RamiroSGaspar/ChalecoSOC_2023/AppMovil_ChalecoSOC/Codigo_bloques_APPChalecoSOC.jpeg

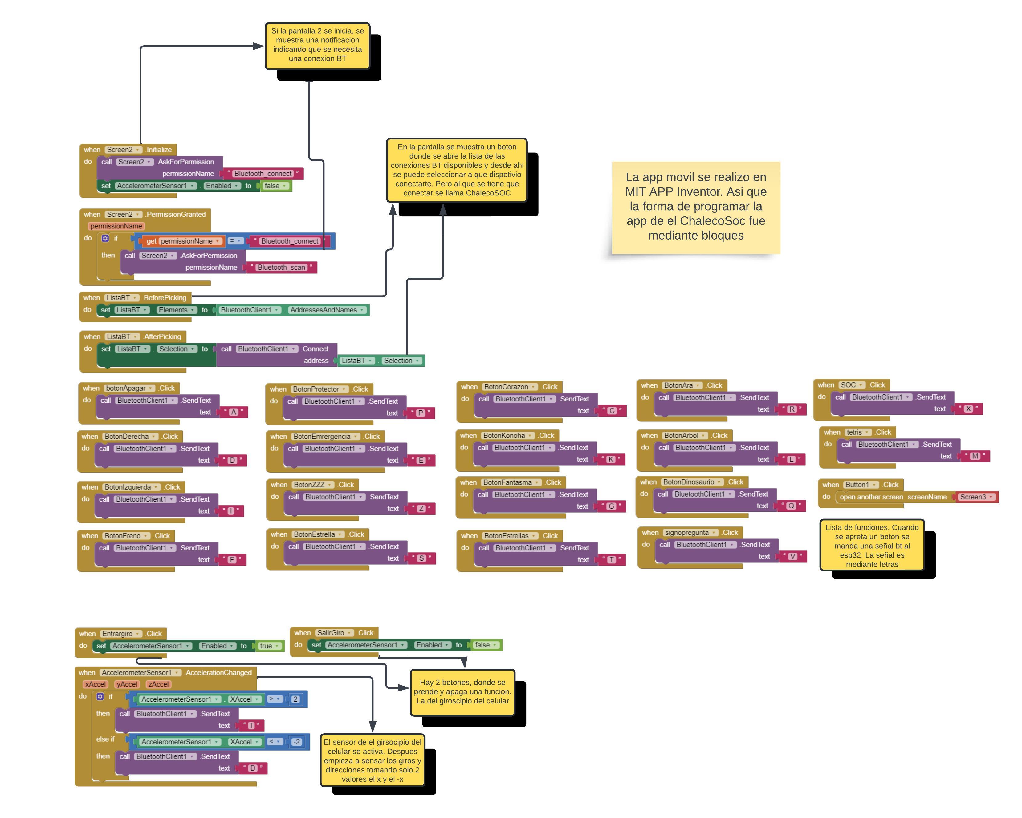
AppMovil_ChalecoSOC/Codigo_bloques_APPChalecoSOC.jpeg
