RamiroSGaspar/ChalecoSOC_2023/Software_ChalecoSOC/CodigoESP32/CodigoESP32.ino

// Autor: Ramiro Sebastian Gaspar
// Fecha: 27/08/24
// Proyecto: Chaleco SOC
// Institucion: E.E.T 3139 Gral. M.M de Guemes, Salta Capital
// Version: 1.0 (version final)

// Proposito: Este es un programa que se une con el hardware de el ChalecoSOC. Este codigo permite que el microcontrolador
//pueda recibir señales bt que contienen letras. Estas letras son interpretadas por el codigo y muestra manda una sucecion
//de comandos para que las luces led inteligentes puedan interpretarlas y traducirla a los distintos colores, asi formando
//la imagen o la animacion.

// Notas: Las letras ya estan almacenadas en la aplicacion movil asi que si el esp32 detecta que se pulsa una letra se manda
//las señales a los leds. Ademas, este codigo no es funcional en otros microcontroladores como Arduino UNO, debido a que los
//comandos de las secuencias de luces ocupan mucho espacio, y esos micros no cuentan con la capacidad para almacenar tantos,
//puede funcionar si se le amplian la memoria pero se convierte en en gasto mas.


//se importan las librerias necesarias
#include <Adafruit_NeoPixel.h> //libreria que permite el control de los leds
#include <BluetoothSerial.h> //libreria que permite el uso del bluetooth del esp32

int brillo = 12; // se declara el brillo de los leds
int leds = 288; // cantidad de leds
int tiempo = 1000; //este se utiliza para funciones extras

Adafruit_NeoPixel tira = Adafruit_NeoPixel(leds, 13, NEO_GRB + NEO_KHZ800); //se declara el pin de datos y el nombre de esta "tira"
BluetoothSerial SerialBT; //esta instancia se utiliza para configurar y gestionar la comunicación Bluetooth


void setup() { // este inicia el programa
  tira.begin(); // se utiliza en un proyecto que controla una tira de luces
  tira.setBrightness(brillo); // se utiliza para controlar el brillo
  tira.show(); // prende los pixeles con su configuracion 
  Serial.begin(115200); // inicializa  la comunicación serial en una placa 
  SerialBT.begin("ChalecoSOC"); // es el nombre que aparece en los dispositivos que se conecten al esp32
}

void loop() { // ejecuta continuamente el programa
  
  if (SerialBT.available()){ // condicion que si el bt esta activado entonces...
    char BT = SerialBT.read(); //  lee datos de una conexión Bluetooth a través de un módulo Bluetooth configurado previamente
  
    switch (BT) { // lista de los datos
      //FUNCIONES DE CICLISMO:
//apagar
      case 'A':
      tira.setPixelColor(0,0,0,0);tira.setPixelColor(1,0,0,0);tira.setPixelColor(2,0,0,0);tira.setPixelColor(3,0,0,0);tira.setPixelColor(4,0,0,0);tira.setPixelColor(5,0,0,0);tira.setPixelColor(6,0,0,0);tira.setPixelColor(7,0,0,0);tira.setPixelColor(8,0,0,0);tira.setPixelColor(9,0,0,0);tira.setPixelC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
xelColor(195,255,255,0);tira.setPixelColor(196,0,0,0);tira.setPixelColor(197,0,0,0);tira.setPixelColor(198,0,0,0);tira.setPixelColor(199,0,0,0);tira.setPixelColor(200,0,0,0);tira.setPixelColor(201,0,0,0);tira.setPixelColor(202,0,0,0);tira.setPixelColor(203,0,0,0);tira.setPixelColor(204,0,0,0);tira.setPixelColor(205,0,0,0);tira.setPixelColor(206,255,255,0);tira.setPixelColor(207,255,255,0);tira.setPixelColor(208,0,0,0);tira.setPixelColor(209,255,255,0);tira.setPixelColor(210,255,255,0);tira.setPixelColor(211,255,255,0);tira.setPixelColor(212,255,255,0);tira.setPixelColor(213,0,0,0);tira.setPixelColor(214,0,0,0);tira.setPixelColor(215,0,0,0);tira.setPixelColor(216,0,0,0);tira.setPixelColor(217,0,0,0);tira.setPixelColor(218,0,0,0);tira.setPixelColor(219,0,0,0);tira.setPixelColor(220,0,0,0);tira.setPixelColor(221,0,0,0);tira.setPixelColor(222,0,0,0);tira.setPixelColor(223,0,0,0);tira.setPixelColor(224,255,255,0);tira.setPixelColor(225,255,255,0);tira.setPixelColor(226,255,255,0);tira.setPixelColor(227,255,255,0);tira.setPixelColor(228,255,255,0);tira.setPixelColor(229,255,255,0);tira.setPixelColor(230,0,0,0);tira.setPixelColor(231,0,0,0);tira.setPixelColor(232,0,0,0);tira.setPixelColor(233,0,0,0);tira.setPixelColor(234,0,0,0);tira.setPixelColor(235,0,0,0);tira.setPixelColor(236,0,0,0);tira.setPixelColor(237,0,0,0);tira.setPixelColor(238,0,0,0);tira.setPixelColor(239,0,0,0);tira.setPixelColor(240,0,0,0);tira.setPixelColor(241,0,0,0);tira.setPixelColor(242,255,255,0);tira.setPixelColor(243,255,255,0);tira.setPixelColor(244,255,255,0);tira.setPixelColor(245,255,255,0);tira.setPixelColor(246,255,255,0);tira.setPixelColor(247,0,0,0);tira.setPixelColor(248,0,0,0);tira.setPixelColor(249,0,0,0);tira.setPixelColor(250,0,0,0);tira.setPixelColor(251,0,0,0);tira.setPixelColor(252,0,0,0);tira.setPixelColor(253,0,0,0);tira.setPixelColor(254,0,0,0);tira.setPixelColor(255,0,0,0);tira.setPixelColor(256,0,0,0);tira.setPixelColor(257,0,0,0);tira.setPixelColor(258,0,0,0);tira.setPixelColor(259,0,0,0);tira.setPixelColor(260,255,255,0);tira.setPixelColor(261,255,255,0);tira.setPixelColor(262,255,255,0);tira.setPixelColor(263,255,255,0);tira.setPixelColor(264,0,0,0);tira.setPixelColor(265,0,0,0);tira.setPixelColor(266,0,0,0);tira.setPixelColor(267,0,0,0);tira.setPixelColor(268,0,0,0);tira.setPixelColor(269,0,0,0);tira.setPixelColor(270,0,0,0);tira.setPixelColor(271,0,0,0);tira.setPixelColor(272,0,0,0);tira.setPixelColor(273,0,0,0);tira.setPixelColor(274,0,0,0);tira.setPixelColor(275,0,0,0);tira.setPixelColor(276,0,0,0);tira.setPixelColor(277,0,0,0);tira.setPixelColor(278,0,0,0);tira.setPixelColor(279,0,0,0);tira.setPixelColor(280,0,0,0);tira.setPixelColor(281,0,0,0);tira.setPixelColor(282,0,0,0);tira.setPixelColor(283,0,0,0);tira.setPixelColor(284,0,0,0);tira.setPixelColor(285,0,0,0);tira.setPixelColor(286,0,0,0);tira.setPixelColor(287,0,0,0);
      tira.show();
      break;
//Izquierda
      case'I':
      tira.setPixelColor(0,0,0,0);tira.setPixelColor(1,0,0,0);tira.setPixelColor(2,0,0,0);tira.setPixelColor(3,0,0,0);tira.setPixelColor(4,0,0,0);tira.setPixelColor(5,0,0,0);tira.setPixelColor(6,255,255,0);tira.setPixelColor(7,255,255,0);tira.setPixelColor(8,255,255,0);tira.setPixelColor(9,255,255,0);tira.setPixelColor(10,0,0,0);tira.setPixelColor(11,0,0,0);tira.setPixelColor(12,0,0,0);tira.setPixelColor(13,0,0,0);tira.setPixelColor(14,0,0,0);tira.setPixelColor(15,0,0,0);tira.setPixelColor(16,0,0,0);tira.setPixelColor(17,0,0,0);tira.setPixelColor(18,0,0,0);tira.setPixelColor(19,0,0,0);tira.setPixelColor(20,0,0,0);tira.setPixelColor(21,0,0,0);tira.setPixelColor(22,0,0,0);tira.setPixelColor(23,255,255,0);tira.setPixelColor(24,255,255,0);tira.setPixelColor(25,255,255,0);tira.setPixelColor(26,255,255,0);tira.setPixelColor(27,255,255,0);tira.setPixelColor(28,0,0,0);tira.setPixelColor(29,0,0,0);tira.setPixelColor(30,0,0,0);tira.setPixelColor(31,0,0,0);tira.setPixelColor(32,0,0,0);tira.setPixelColor(33,0,0,0);tira.setPixelColor(34,0,0,0);tira.setPixelColor(35,0,0,0);tira.setPixelColor(36,0,0,0);tira.setPixelColor(37,0,0,0);tira.setPixelColor(38,0,0,0);tira.setPixelColor(39,0,0,0);tira.setPixelColor(40,255,255,0);tira.setPixelColor(41,255,255,0);tira.setPixelColor(42,255,255,0);tira.setPixelColor(43,255,255,0);tira.setPixelColor(44,255,255,0);tira.setPixelColor(45,255,255,0);tira.setPixelColor(46,0,0,0);tira.setPixelColor(47,0,0,0);tira.setPixelColor(48,0,0,0);tira.setPixelColor(49,0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
etPixelColor(195,0,0,0);tira.setPixelColor(196,0,0,0);tira.setPixelColor(197,0,0,0);tira.setPixelColor(198,0,0,0);tira.setPixelColor(199,0,0,0);tira.setPixelColor(200,0,0,0);tira.setPixelColor(201,255,255,0);tira.setPixelColor(202,255,255,0);tira.setPixelColor(203,255,255,0);tira.setPixelColor(204,255,255,0);tira.setPixelColor(205,0,0,0);tira.setPixelColor(206,255,255,0);tira.setPixelColor(207,255,255,0);tira.setPixelColor(208,0,0,0);tira.setPixelColor(209,0,0,0);tira.setPixelColor(210,0,0,0);tira.setPixelColor(211,0,0,0);tira.setPixelColor(212,0,0,0);tira.setPixelColor(213,0,0,0);tira.setPixelColor(214,0,0,0);tira.setPixelColor(215,0,0,0);tira.setPixelColor(216,0,0,0);tira.setPixelColor(217,0,0,0);tira.setPixelColor(218,0,0,0);tira.setPixelColor(219,0,0,0);tira.setPixelColor(220,255,255,0);tira.setPixelColor(221,255,255,0);tira.setPixelColor(222,255,255,0);tira.setPixelColor(223,255,255,0);tira.setPixelColor(224,255,255,0);tira.setPixelColor(225,255,255,0);tira.setPixelColor(226,0,0,0);tira.setPixelColor(227,0,0,0);tira.setPixelColor(228,0,0,0);tira.setPixelColor(229,0,0,0);tira.setPixelColor(230,0,0,0);tira.setPixelColor(231,0,0,0);tira.setPixelColor(232,0,0,0);tira.setPixelColor(233,0,0,0);tira.setPixelColor(234,0,0,0);tira.setPixelColor(235,0,0,0);tira.setPixelColor(236,0,0,0);tira.setPixelColor(237,0,0,0);tira.setPixelColor(238,0,0,0);tira.setPixelColor(239,255,255,0);tira.setPixelColor(240,255,255,0);tira.setPixelColor(241,255,255,0);tira.setPixelColor(242,255,255,0);tira.setPixelColor(243,255,255,0);tira.setPixelColor(244,0,0,0);tira.setPixelColor(245,0,0,0);tira.setPixelColor(246,0,0,0);tira.setPixelColor(247,0,0,0);tira.setPixelColor(248,0,0,0);tira.setPixelColor(249,0,0,0);tira.setPixelColor(250,0,0,0);tira.setPixelColor(251,0,0,0);tira.setPixelColor(252,0,0,0);tira.setPixelColor(253,0,0,0);tira.setPixelColor(254,0,0,0);tira.setPixelColor(255,0,0,0);tira.setPixelColor(256,0,0,0);tira.setPixelColor(257,0,0,0);tira.setPixelColor(258,255,255,0);tira.setPixelColor(259,255,255,0);tira.setPixelColor(260,255,255,0);tira.setPixelColor(261,255,255,0);tira.setPixelColor(262,0,0,0);tira.setPixelColor(263,0,0,0);tira.setPixelColor(264,0,0,0);tira.setPixelColor(265,0,0,0);tira.setPixelColor(266,0,0,0);tira.setPixelColor(267,0,0,0);tira.setPixelColor(268,0,0,0);tira.setPixelColor(269,0,0,0);tira.setPixelColor(270,0,0,0);tira.setPixelColor(271,0,0,0);tira.setPixelColor(272,0,0,0);tira.setPixelColor(273,0,0,0);tira.setPixelColor(274,0,0,0);tira.setPixelColor(275,0,0,0);tira.setPixelColor(276,0,0,0);tira.setPixelColor(277,0,0,0);tira.setPixelColor(278,0,0,0);tira.setPixelColor(279,0,0,0);tira.setPixelColor(280,0,0,0);tira.setPixelColor(281,0,0,0);tira.setPixelColor(282,0,0,0);tira.setPixelColor(283,0,0,0);tira.setPixelColor(284,0,0,0);tira.setPixelColor(285,0,0,0);tira.setPixelColor(286,0,0,0);tira.setPixelColor(287,0,0,0);
      tira.show();
      break;
//Freno
      case 'F':
      tira.setPixelColor(0,0,0,0);tira.setPixelColor(1,0,0,0);tira.setPixelColor(2,0,0,0);tira.setPixelColor(3,0,0,0);tira.setPixelColor(4,0,0,0);tira.setPixelColor(5,0,0,0);tira.setPixelColor(6,0,0,0);tira.setPixelColor(7,0,0,0);tira.setPixelColor(8,255,0,0);tira.setPixelColor(9,255,0,0);tira.setPixelColor(10,0,0,0);tira.setPixelColor(11,0,0,0);tira.setPixelColor(12,0,0,0);tira.setPixelColor(13,0,0,0);tira.setPixelColor(14,0,0,0);tira.setPixelColor(15,0,0,0);tira.setPixelColor(16,0,0,0);tira.setPixelColor(17,0,0,0);tira.setPixelColor(18,0,0,0);tira.setPixelColor(19,0,0,0);tira.setPixelColor(20,0,0,0);tira.setPixelColor(21,0,0,0);tira.setPixelColor(22,0,0,0);tira.setPixelColor(23,0,0,0);tira.setPixelColor(24,0,0,0);tira.setPixelColor(25,255,0,0);tira.setPixelColor(26,255,0,0);tira.setPixelColor(27,255,0,0);tira.setPixelColor(28,255,0,0);tira.setPixelColor(29,0,0,0);tira.setPixelColor(30,0,0,0);tira.setPixelColor(31,0,0,0);tira.setPixelColor(32,0,0,0);tira.setPixelColor(33,0,0,0);tira.setPixelColor(34,0,0,0);tira.setPixelColor(35,0,0,0);tira.setPixelColor(36,0,0,0);tira.setPixelColor(37,0,0,0);tira.setPixelColor(38,0,0,0);tira.setPixelColor(39,0,0,0);tira.setPixelColor(40,0,0,0);tira.setPixelColor(41,0,0,0);tira.setPixelColor(42,255,0,0);tira.setPixelColor(43,255,0,0);tira.setPixelColor(44,0,0,0);tira.setPixelColor(45,0,0,0);tira.setPixelColor(46,255,0,0);tira.setPixelColor(47,255,0,0);tira.setPixelColor(48,0,0,0);tira.setPixelColor(49,0,0,0);tira.setPixelColor(50,0,0,0);tira.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
00,0,0,0);tira.setPixelColor(201,0,0,0);tira.setPixelColor(202,255,0,0);tira.setPixelColor(203,255,0,0);tira.setPixelColor(204,0,0,0);tira.setPixelColor(205,0,0,0);tira.setPixelColor(206,0,0,0);tira.setPixelColor(207,0,0,0);tira.setPixelColor(208,0,0,0);tira.setPixelColor(209,0,0,0);tira.setPixelColor(210,255,0,0);tira.setPixelColor(211,255,0,0);tira.setPixelColor(212,0,0,0);tira.setPixelColor(213,0,0,0);tira.setPixelColor(214,0,0,0);tira.setPixelColor(215,0,0,0);tira.setPixelColor(216,0,0,0);tira.setPixelColor(217,0,0,0);tira.setPixelColor(218,0,0,0);tira.setPixelColor(219,0,0,0);tira.setPixelColor(220,0,0,0);tira.setPixelColor(221,255,0,0);tira.setPixelColor(222,255,0,0);tira.setPixelColor(223,0,0,0);tira.setPixelColor(224,0,0,0);tira.setPixelColor(225,0,0,0);tira.setPixelColor(226,0,0,0);tira.setPixelColor(227,255,0,0);tira.setPixelColor(228,255,0,0);tira.setPixelColor(229,0,0,0);tira.setPixelColor(230,0,0,0);tira.setPixelColor(231,0,0,0);tira.setPixelColor(232,0,0,0);tira.setPixelColor(233,0,0,0);tira.setPixelColor(234,0,0,0);tira.setPixelColor(235,0,0,0);tira.setPixelColor(236,0,0,0);tira.setPixelColor(237,0,0,0);tira.setPixelColor(238,0,0,0);tira.setPixelColor(239,0,0,0);tira.setPixelColor(240,255,0,0);tira.setPixelColor(241,255,0,0);tira.setPixelColor(242,0,0,0);tira.setPixelColor(243,0,0,0);tira.setPixelColor(244,255,0,0);tira.setPixelColor(245,255,0,0);tira.setPixelColor(246,0,0,0);tira.setPixelColor(247,0,0,0);tira.setPixelColor(248,0,0,0);tira.setPixelColor(249,0,0,0);tira.setPixelColor(250,0,0,0);tira.setPixelColor(251,0,0,0);tira.setPixelColor(252,0,0,0);tira.setPixelColor(253,0,0,0);tira.setPixelColor(254,0,0,0);tira.setPixelColor(255,0,0,0);tira.setPixelColor(256,0,0,0);tira.setPixelColor(257,0,0,0);tira.setPixelColor(258,0,0,0);tira.setPixelColor(259,255,0,0);tira.setPixelColor(260,255,0,0);tira.setPixelColor(261,255,0,0);tira.setPixelColor(262,255,0,0);tira.setPixelColor(263,0,0,0);tira.setPixelColor(264,0,0,0);tira.setPixelColor(265,0,0,0);tira.setPixelColor(266,0,0,0);tira.setPixelColor(267,0,0,0);tira.setPixelColor(268,0,0,0);tira.setPixelColor(269,0,0,0);tira.setPixelColor(270,0,0,0);tira.setPixelColor(271,0,0,0);tira.setPixelColor(272,0,0,0);tira.setPixelColor(273,0,0,0);tira.setPixelColor(274,0,0,0);tira.setPixelColor(275,0,0,0);tira.setPixelColor(276,0,0,0);tira.setPixelColor(277,0,0,0);tira.setPixelColor(278,255,0,0);tira.setPixelColor(279,255,0,0);tira.setPixelColor(280,0,0,0);tira.setPixelColor(281,0,0,0);tira.setPixelColor(282,0,0,0);tira.setPixelColor(283,0,0,0);tira.setPixelColor(284,0,0,0);tira.setPixelColor(285,0,0,0);tira.setPixelColor(286,0,0,0);tira.setPixelColor(287,0,0,0);
      tira.show();
      break;
      
//FUNCIONES EXTRA:
//Konoha
      case 'K':
      tira.setPixelColor(0,0,0,0);tira.setPixelColor(1,0,0,0);tira.setPixelColor(2,0,0,0);tira.setPixelColor(3,0,0,0);tira.setPixelColor(4,0,0,0);tira.setPixelColor(5,0,0,0);tira.setPixelColor(6,0,0,0);tira.setPixelColor(7,0,0,0);tira.setPixelColor(8,0,0,0);tira.setPixelColor(9,255,255,255);tira.setPixelColor(10,255,255,255);tira.setPixelColor(11,255,255,255);tira.setPixelColor(12,0,0,0);tira.setPixelColor(13,0,0,0);tira.setPixelColor(14,0,0,0);tira.setPixelColor(15,0,0,0);tira.setPixelColor(16,0,0,0);tira.setPixelColor(17,255,255,255);tira.setPixelColor(18,0,0,0);tira.setPixelColor(19,0,0,0);tira.setPixelColor(20,0,0,0);tira.setPixelColor(21,0,0,0);tira.setPixelColor(22,0,0,0);tira.setPixelColor(23,0,0,0);tira.setPixelColor(24,0,0,0);tira.setPixelColor(25,255,255,255);tira.setPixelColor(26,255,255,255);tira.setPixelColor(27,255,255,255);tira.setPixelColor(28,255,255,255);tira.setPixelColor(29,255,255,255);tira.setPixelColor(30,255,255,255);tira.setPixelColor(31,255,255,255);tira.setPixelColor(32,0,0,0);tira.setPixelColor(33,0,0,0);tira.setPixelColor(34,255,255,255);tira.setPixelColor(35,255,255,255);tira.setPixelColor(36,0,0,0);tira.setPixelColor(37,0,0,0);tira.setPixelColor(38,0,0,0);tira.setPixelColor(39,0,0,0);tira.setPixelColor(40,0,0,0);tira.setPixelColor(41,0,0,0);tira.setPixelColor(42,0,0,0);tira.setPixelColor(43,255,255,255);tira.setPixelColor(44,255,255,255);tira.setPixelColor(45,0,0,0);tira.setPixelColor(46,0,0,0);tira.setPixelColor(47,0,0,0);tira.setPixelColor(48,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
85,0,0,0);tira.setPixelColor(286,0,0,0);tira.setPixelColor(287,0,0,0);
      tira.show();
      break;
//Arbol
      case 'L':
      tira.setPixelColor(0,0,0,0);tira.setPixelColor(1,0,0,0);tira.setPixelColor(2,0,0,0);tira.setPixelColor(3,0,0,0);tira.setPixelColor(4,0,0,0);tira.setPixelColor(5,0,0,0);tira.setPixelColor(6,0,0,0);tira.setPixelColor(7,0,0,0);tira.setPixelColor(8,255,255,0);tira.setPixelColor(9,255,255,0);tira.setPixelColor(10,0,0,0);tira.setPixelColor(11,0,0,0);tira.setPixelColor(12,0,0,0);tira.setPixelColor(13,0,0,0);tira.setPixelColor(14,0,0,0);tira.setPixelColor(15,0,0,0);tira.setPixelColor(16,0,0,0);tira.setPixelColor(17,0,0,0);tira.setPixelColor(18,0,0,0);tira.setPixelColor(19,0,0,0);tira.setPixelColor(20,0,0,0);tira.setPixelColor(21,0,0,0);tira.setPixelColor(22,0,0,0);tira.setPixelColor(23,0,0,0);tira.setPixelColor(24,0,0,0);tira.setPixelColor(25,0,0,0);tira.setPixelColor(26,255,255,0);tira.setPixelColor(27,255,255,0);tira.setPixelColor(28,0,0,0);tira.setPixelColor(29,0,0,0);tira.setPixelColor(30,0,0,0);tira.setPixelColor(31,0,0,0);tira.setPixelColor(32,0,0,0);tira.setPixelColor(33,0,0,0);tira.setPixelColor(34,0,0,0);tira.setPixelColor(35,0,0,0);tira.setPixelColor(36,0,0,0);tira.setPixelColor(37,0,0,0);tira.setPixelColor(38,0,0,0);tira.setPixelColor(39,0,0,0);tira.setPixelColor(40,0,0,0);tira.setPixelColor(41,0,0,0);tira.setPixelColor(42,0,0,0);tira.setPixelColor(43,0,0,0);tira.setPixelColor(44,0,255,0);tira.setPixelColor(45,0,255,0);tira.setPixelColor(46,0,0,0);tira.setPixelColor(47,0,0,0);tira.setPixelColor(48,0,0,0);tira.setPixelColor(49,0,0,0);tira.setPixelColor(50,0,0,0);tira.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
etPixelColor(197,0,0,0);tira.setPixelColor(198,0,0,0);tira.setPixelColor(199,0,255,0);tira.setPixelColor(200,0,255,0);tira.setPixelColor(201,0,255,0);tira.setPixelColor(202,0,255,0);tira.setPixelColor(203,0,255,0);tira.setPixelColor(204,0,255,0);tira.setPixelColor(205,0,255,0);tira.setPixelColor(206,0,255,0);tira.setPixelColor(207,0,255,0);tira.setPixelColor(208,0,255,0);tira.setPixelColor(209,0,255,0);tira.setPixelColor(210,0,255,0);tira.setPixelColor(211,0,255,0);tira.setPixelColor(212,0,255,0);tira.setPixelColor(213,0,255,0);tira.setPixelColor(214,0,255,255);tira.setPixelColor(215,0,0,0);tira.setPixelColor(216,0,0,0);tira.setPixelColor(217,0,255,0);tira.setPixelColor(218,0,255,0);tira.setPixelColor(219,0,255,0);tira.setPixelColor(220,0,255,0);tira.setPixelColor(221,0,255,0);tira.setPixelColor(222,0,255,0);tira.setPixelColor(223,0,255,0);tira.setPixelColor(224,0,255,0);tira.setPixelColor(225,0,255,0);tira.setPixelColor(226,0,255,0);tira.setPixelColor(227,0,255,0);tira.setPixelColor(228,0,255,0);tira.setPixelColor(229,0,255,0);tira.setPixelColor(230,0,255,0);tira.setPixelColor(231,0,255,0);tira.setPixelColor(232,0,255,0);tira.setPixelColor(233,0,0,0);tira.setPixelColor(234,0,255,0);tira.setPixelColor(235,0,255,255);tira.setPixelColor(236,0,255,0);tira.setPixelColor(237,0,255,0);tira.setPixelColor(238,0,255,0);tira.setPixelColor(239,0,255,0);tira.setPixelColor(240,0,255,0);tira.setPixelColor(241,0,255,0);tira.setPixelColor(242,100,40,40);tira.setPixelColor(243,100,40,40);tira.setPixelColor(244,0,255,0);tira.setPixelColor(245,0,255,0);tira.setPixelColor(246,0,255,0);tira.setPixelColor(247,0,255,0);tira.setPixelColor(248,0,255,0);tira.setPixelColor(249,0,255,0);tira.setPixelColor(250,0,255,0);tira.setPixelColor(251,0,255,255);tira.setPixelColor(252,210,105,30);tira.setPixelColor(253,0,255,0);tira.setPixelColor(254,0,255,0);tira.setPixelColor(255,0,255,0);tira.setPixelColor(256,0,255,0);tira.setPixelColor(257,0,255,0);tira.setPixelColor(258,0,255,0);tira.setPixelColor(259,0,255,0);tira.setPixelColor(260,100,40,40);tira.setPixelColor(261,100,40,40);tira.setPixelColor(262,0,255,0);tira.setPixelColor(263,0,255,0);tira.setPixelColor(264,0,255,0);tira.setPixelColor(265,0,255,0);tira.setPixelColor(266,0,255,0);tira.setPixelColor(267,0,255,0);tira.setPixelColor(268,0,255,0);tira.setPixelColor(269,0,255,0);tira.setPixelColor(270,0,0,0);tira.setPixelColor(271,0,0,0);tira.setPixelColor(272,0,0,0);tira.setPixelColor(273,0,0,0);tira.setPixelColor(274,0,0,0);tira.setPixelColor(275,0,0,0);tira.setPixelColor(276,0,0,0);tira.setPixelColor(277,0,0,0);tira.setPixelColor(278,100,40,40);tira.setPixelColor(279,100,40,40);tira.setPixelColor(280,0,0,0);tira.setPixelColor(281,0,0,0);tira.setPixelColor(282,0,0,0);tira.setPixelColor(283,0,0,0);tira.setPixelColor(284,0,0,0);tira.setPixelColor(285,0,0,0);tira.setPixelColor(286,0,0,0);tira.setPixelColor(287,0,0,0);
      tira.show();
      break;
//Araña
      case 'R':
      tira.setPixelColor(0,0,0,0);tira.setPixelColor(1,0,0,0);tira.setPixelColor(2,0,0,0);tira.setPixelColor(3,0,0,0);tira.setPixelColor(4,0,0,0);tira.setPixelColor(5,0,0,0);tira.setPixelColor(6,0,0,0);tira.setPixelColor(7,0,0,0);tira.setPixelColor(8,0,0,0);tira.setPixelColor(9,0,0,0);tira.setPixelColor(10,0,0,0);tira.setPixelColor(11,0,0,0);tira.setPixelColor(12,0,0,0);tira.setPixelColor(13,0,0,0);tira.setPixelColor(14,0,0,0);tira.setPixelColor(15,0,0,0);tira.setPixelColor(16,0,0,0);tira.setPixelColor(17,0,0,0);tira.setPixelColor(18,0,0,0);tira.setPixelColor(19,0,0,0);tira.setPixelColor(20,0,0,0);tira.setPixelColor(21,255,0,0);tira.setPixelColor(22,0,0,0);tira.setPixelColor(23,0,0,0);tira.setPixelColor(24,0,0,0);tira.setPixelColor(25,0,0,0);tira.setPixelColor(26,0,0,0);tira.setPixelColor(27,0,0,0);tira.setPixelColor(28,0,0,0);tira.setPixelColor(29,0,0,0);tira.setPixelColor(30,0,0,0);tira.setPixelColor(31,255,0,0);tira.setPixelColor(32,0,0,0);tira.setPixelColor(33,0,0,0);tira.setPixelColor(34,0,0,0);tira.setPixelColor(35,0,0,0);tira.setPixelColor(36,0,0,0);tira.setPixelColor(37,0,0,0);tira.setPixelColor(38,0,0,0);tira.setPixelColor(39,255,0,0);tira.setPixelColor(40,0,0,0);tira.setPixelColor(41,0,0,0);tira.setPixelColor(42,0,0,0);tira.setPixelColor(43,0,0,0);tira.setPixelColor(44,0,0,0);tira.setPixelColor(45,0,0,0);tira.setPixelColor(46,0,0,0);tira.setPixelColor(47,0,0,0);tira.setPixelColor(48,0,0,0);tira.setPixelColor(49,255,0,0);tira.setPixelColor(50,0,0,0);tira.setPixelColo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
,0);tira.setPixelColor(200,0,0,0);tira.setPixelColor(201,0,0,0);tira.setPixelColor(202,255,0,0);tira.setPixelColor(203,255,0,0);tira.setPixelColor(204,0,0,0);tira.setPixelColor(205,255,0,0);tira.setPixelColor(206,255,0,0);tira.setPixelColor(207,255,0,0);tira.setPixelColor(208,0,0,0);tira.setPixelColor(209,255,0,0);tira.setPixelColor(210,255,0,0);tira.setPixelColor(211,0,0,0);tira.setPixelColor(212,0,0,0);tira.setPixelColor(213,0,0,0);tira.setPixelColor(214,0,0,0);tira.setPixelColor(215,0,0,0);tira.setPixelColor(216,0,0,0);tira.setPixelColor(217,0,0,0);tira.setPixelColor(218,255,0,0);tira.setPixelColor(219,255,0,0);tira.setPixelColor(220,0,0,0);tira.setPixelColor(221,0,0,0);tira.setPixelColor(222,255,0,0);tira.setPixelColor(223,0,0,0);tira.setPixelColor(224,255,0,0);tira.setPixelColor(225,0,0,0);tira.setPixelColor(226,255,0,0);tira.setPixelColor(227,0,0,0);tira.setPixelColor(228,0,0,0);tira.setPixelColor(229,255,0,0);tira.setPixelColor(230,255,0,0);tira.setPixelColor(231,0,0,0);tira.setPixelColor(232,0,0,0);tira.setPixelColor(233,0,0,0);tira.setPixelColor(234,0,0,0);tira.setPixelColor(235,0,0,0);tira.setPixelColor(236,0,0,0);tira.setPixelColor(237,0,0,0);tira.setPixelColor(238,0,0,0);tira.setPixelColor(239,255,0,0);tira.setPixelColor(240,0,0,0);tira.setPixelColor(241,0,0,0);tira.setPixelColor(242,0,0,0);tira.setPixelColor(243,0,0,0);tira.setPixelColor(244,0,0,0);tira.setPixelColor(245,255,0,0);tira.setPixelColor(246,0,0,0);tira.setPixelColor(247,0,0,0);tira.setPixelColor(248,0,0,0);tira.setPixelColor(249,0,0,0);tira.setPixelColor(250,0,0,0);tira.setPixelColor(251,0,0,0);tira.setPixelColor(252,0,0,0);tira.setPixelColor(253,0,0,0);tira.setPixelColor(254,0,0,0);tira.setPixelColor(255,0,0,0);tira.setPixelColor(256,0,0,0);tira.setPixelColor(257,255,0,0);tira.setPixelColor(258,0,0,0);tira.setPixelColor(259,0,0,0);tira.setPixelColor(260,0,0,0);tira.setPixelColor(261,0,0,0);tira.setPixelColor(262,0,0,0);tira.setPixelColor(263,255,0,0);tira.setPixelColor(264,0,0,0);tira.setPixelColor(265,0,0,0);tira.setPixelColor(266,0,0,0);tira.setPixelColor(267,0,0,0);tira.setPixelColor(268,0,0,0);tira.setPixelColor(269,0,0,0);tira.setPixelColor(270,0,0,0);tira.setPixelColor(271,0,0,0);tira.setPixelColor(272,0,0,0);tira.setPixelColor(273,255,0,0);tira.setPixelColor(274,255,0,0);tira.setPixelColor(275,0,0,0);tira.setPixelColor(276,0,0,0);tira.setPixelColor(277,0,0,0);tira.setPixelColor(278,0,0,0);tira.setPixelColor(279,0,0,0);tira.setPixelColor(280,0,0,0);tira.setPixelColor(281,0,0,0);tira.setPixelColor(282,255,0,0);tira.setPixelColor(283,255,0,0);tira.setPixelColor(284,0,0,0);tira.setPixelColor(285,0,0,0);tira.setPixelColor(286,0,0,0);tira.setPixelColor(287,0,0,0);
      tira.show();
      break;
//Emergencia
      case 'E':
      tira.setPixelColor(0,0,0,0);tira.setPixelColor(1,0,0,0);tira.setPixelColor(2,0,0,0);tira.setPixelColor(3,0,0,0);tira.setPixelColor(4,0,0,0);tira.setPixelColor(5,0,0,0);tira.setPixelColor(6,0,0,0);tira.setPixelColor(7,0,0,0);tira.setPixelColor(8,0,0,0);tira.setPixelColor(9,0,0,0);tira.setPixelColor(10,0,0,0);tira.setPixelColor(11,0,0,0);tira.setPixelColor(12,0,0,0);tira.setPixelColor(13,0,0,0);tira.setPixelColor(14,0,0,0);tira.setPixelColor(15,0,0,0);tira.setPixelColor(16,0,0,0);tira.setPixelColor(17,0,0,0);tira.setPixelColor(18,0,0,0);tira.setPixelColor(19,0,0,0);tira.setPixelColor(20,0,0,0);tira.setPixelColor(21,0,0,0);tira.setPixelColor(22,0,0,0);tira.setPixelColor(23,0,0,0);tira.setPixelColor(24,0,0,0);tira.setPixelColor(25,0,0,0);tira.setPixelColor(26,0,0,0);tira.setPixelColor(27,0,0,0);tira.setPixelColor(28,0,0,0);tira.setPixelColor(29,0,0,0);tira.setPixelColor(30,0,0,0);tira.setPixelColor(31,0,0,0);tira.setPixelColor(32,0,0,0);tira.setPixelColor(33,0,0,0);tira.setPixelColor(34,0,0,0);tira.setPixelColor(35,0,0,0);tira.setPixelColor(36,0,0,0);tira.setPixelColor(37,0,0,0);tira.setPixelColor(38,0,0,0);tira.setPixelColor(39,0,0,0);tira.setPixelColor(40,0,0,0);tira.setPixelColor(41,0,0,0);tira.setPixelColor(42,0,0,0);tira.setPixelColor(43,0,0,0);tira.setPixelColor(44,0,0,0);tira.setPixelColor(45,0,0,0);tira.setPixelColor(46,0,0,0);tira.setPixelColor(47,0,0,0);tira.setPixelColor(48,0,0,0);tira.setPixelColor(49,0,0,0);tira.setPixelColor(50,0,0,0);tira.setPixelColor(51,0,0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
lColor(198,0,0,0);tira.setPixelColor(199,0,0,0);tira.setPixelColor(200,0,0,0);tira.setPixelColor(201,255,255,0);tira.setPixelColor(202,255,255,0);tira.setPixelColor(203,255,255,0);tira.setPixelColor(204,255,255,0);tira.setPixelColor(205,255,255,0);tira.setPixelColor(206,255,255,0);tira.setPixelColor(207,255,255,0);tira.setPixelColor(208,255,255,0);tira.setPixelColor(209,255,255,0);tira.setPixelColor(210,255,255,0);tira.setPixelColor(211,255,255,0);tira.setPixelColor(212,255,255,0);tira.setPixelColor(213,0,0,0);tira.setPixelColor(214,0,0,0);tira.setPixelColor(215,0,0,0);tira.setPixelColor(216,0,0,0);tira.setPixelColor(217,0,0,0);tira.setPixelColor(218,255,255,0);tira.setPixelColor(219,255,255,0);tira.setPixelColor(220,255,255,0);tira.setPixelColor(221,255,255,0);tira.setPixelColor(222,255,255,0);tira.setPixelColor(223,255,255,0);tira.setPixelColor(224,0,0,0);tira.setPixelColor(225,0,0,0);tira.setPixelColor(226,255,255,0);tira.setPixelColor(227,255,255,0);tira.setPixelColor(228,255,255,0);tira.setPixelColor(229,255,255,0);tira.setPixelColor(230,255,255,0);tira.setPixelColor(231,255,255,0);tira.setPixelColor(232,0,0,0);tira.setPixelColor(233,0,0,0);tira.setPixelColor(234,0,0,0);tira.setPixelColor(235,0,0,0);tira.setPixelColor(236,255,255,0);tira.setPixelColor(237,255,255,0);tira.setPixelColor(238,255,255,0);tira.setPixelColor(239,255,255,0);tira.setPixelColor(240,255,255,0);tira.setPixelColor(241,255,255,0);tira.setPixelColor(242,0,0,0);tira.setPixelColor(243,0,0,0);tira.setPixelColor(244,255,255,0);tira.setPixelColor(245,255,255,0);tira.setPixelColor(246,255,255,0);tira.setPixelColor(247,255,255,0);tira.setPixelColor(248,255,255,0);tira.setPixelColor(249,255,255,0);tira.setPixelColor(250,0,0,0);tira.setPixelColor(251,0,0,0);tira.setPixelColor(252,0,0,0);tira.setPixelColor(253,0,0,0);tira.setPixelColor(254,0,0,0);tira.setPixelColor(255,0,0,0);tira.setPixelColor(256,0,0,0);tira.setPixelColor(257,0,0,0);tira.setPixelColor(258,0,0,0);tira.setPixelColor(259,0,0,0);tira.setPixelColor(260,0,0,0);tira.setPixelColor(261,0,0,0);tira.setPixelColor(262,0,0,0);tira.setPixelColor(263,0,0,0);tira.setPixelColor(264,0,0,0);tira.setPixelColor(265,0,0,0);tira.setPixelColor(266,0,0,0);tira.setPixelColor(267,0,0,0);tira.setPixelColor(268,0,0,0);tira.setPixelColor(269,0,0,0);tira.setPixelColor(270,0,0,0);tira.setPixelColor(271,0,0,0);tira.setPixelColor(272,0,0,0);tira.setPixelColor(273,0,0,0);tira.setPixelColor(274,0,0,0);tira.setPixelColor(275,0,0,0);tira.setPixelColor(276,0,0,0);tira.setPixelColor(277,0,0,0);tira.setPixelColor(278,0,0,0);tira.setPixelColor(279,0,0,0);tira.setPixelColor(280,0,0,0);tira.setPixelColor(281,0,0,0);tira.setPixelColor(282,0,0,0);tira.setPixelColor(283,0,0,0);tira.setPixelColor(284,0,0,0);tira.setPixelColor(285,0,0,0);tira.setPixelColor(286,0,0,0);tira.setPixelColor(287,0,0,0);
      tira.show();
      break;
//Corazon
      case 'C':
      tira.setPixelColor(0,0,0,0);tira.setPixelColor(1,0,0,0);tira.setPixelColor(2,0,0,0);tira.setPixelColor(3,0,0,0);tira.setPixelColor(4,0,0,0);tira.setPixelColor(5,0,0,0);tira.setPixelColor(6,0,0,0);tira.setPixelColor(7,0,0,0);tira.setPixelColor(8,0,0,0);tira.setPixelColor(9,0,0,0);tira.setPixelColor(10,0,0,0);tira.setPixelColor(11,0,0,0);tira.setPixelColor(12,0,0,0);tira.setPixelColor(13,0,0,0);tira.setPixelColor(14,0,0,0);tira.setPixelColor(15,0,0,0);tira.setPixelColor(16,0,0,0);tira.setPixelColor(17,0,0,0);tira.setPixelColor(18,0,0,0);tira.setPixelColor(19,0,0,0);tira.setPixelColor(20,0,0,0);tira.setPixelColor(21,0,0,0);tira.setPixelColor(22,0,0,0);tira.setPixelColor(23,0,0,0);tira.setPixelColor(24,0,0,0);tira.setPixelColor(25,0,0,0);tira.setPixelColor(26,0,0,0);tira.setPixelColor(27,0,0,0);tira.setPixelColor(28,0,0,0);tira.setPixelColor(29,0,0,0);tira.setPixelColor(30,0,0,0);tira.setPixelColor(31,0,0,0);tira.setPixelColor(32,0,0,0);tira.setPixelColor(33,0,0,0);tira.setPixelColor(34,0,0,0);tira.setPixelColor(35,0,0,0);tira.setPixelColor(36,0,0,0);tira.setPixelColor(37,0,0,0);tira.setPixelColor(38,0,0,0);tira.setPixelColor(39,0,0,0);tira.setPixelColor(40,255,0,0);tira.setPixelColor(41,255,0,0);tira.setPixelColor(42,255,0,0);tira.setPixelColor(43,0,0,0);tira.setPixelColor(44,0,0,0);tira.setPixelColor(45,0,0,0);tira.setPixelColor(46,0,0,0);tira.setPixelColor(47,255,0,0);tira.setPixelColor(48,255,0,0);tira.setPixelColor(49,255,0,0);tira.setPixelColor(50,0,0,0);tira.setPixel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
xelColor(195,0,0,0);tira.setPixelColor(196,0,0,0);tira.setPixelColor(197,0,0,0);tira.setPixelColor(198,0,0,0);tira.setPixelColor(199,0,0,0);tira.setPixelColor(200,0,0,0);tira.setPixelColor(201,255,0,0);tira.setPixelColor(202,255,0,0);tira.setPixelColor(203,255,0,0);tira.setPixelColor(204,255,0,0);tira.setPixelColor(205,255,0,0);tira.setPixelColor(206,255,0,0);tira.setPixelColor(207,255,0,0);tira.setPixelColor(208,255,0,0);tira.setPixelColor(209,255,0,0);tira.setPixelColor(210,255,0,0);tira.setPixelColor(211,255,0,0);tira.setPixelColor(212,0,0,0);tira.setPixelColor(213,0,0,0);tira.setPixelColor(214,0,0,0);tira.setPixelColor(215,0,0,0);tira.setPixelColor(216,0,0,0);tira.setPixelColor(217,0,0,0);tira.setPixelColor(218,0,0,0);tira.setPixelColor(219,0,0,0);tira.setPixelColor(220,255,0,0);tira.setPixelColor(221,255,0,0);tira.setPixelColor(222,255,0,0);tira.setPixelColor(223,255,0,0);tira.setPixelColor(224,255,0,0);tira.setPixelColor(225,255,0,0);tira.setPixelColor(226,255,0,0);tira.setPixelColor(227,255,0,0);tira.setPixelColor(228,255,0,0);tira.setPixelColor(229,0,0,0);tira.setPixelColor(230,0,0,0);tira.setPixelColor(231,0,0,0);tira.setPixelColor(232,0,0,0);tira.setPixelColor(233,0,0,0);tira.setPixelColor(234,0,0,0);tira.setPixelColor(235,0,0,0);tira.setPixelColor(236,0,0,0);tira.setPixelColor(237,0,0,0);tira.setPixelColor(238,0,0,0);tira.setPixelColor(239,255,0,0);tira.setPixelColor(240,255,0,0);tira.setPixelColor(241,255,0,0);tira.setPixelColor(242,255,0,0);tira.setPixelColor(243,255,0,0);tira.setPixelColor(244,255,0,0);tira.setPixelColor(245,255,0,0);tira.setPixelColor(246,0,0,0);tira.setPixelColor(247,0,0,0);tira.setPixelColor(248,0,0,0);tira.setPixelColor(249,0,0,0);tira.setPixelColor(250,0,0,0);tira.setPixelColor(251,0,0,0);tira.setPixelColor(252,0,0,0);tira.setPixelColor(253,0,0,0);tira.setPixelColor(254,0,0,0);tira.setPixelColor(255,0,0,0);tira.setPixelColor(256,0,0,0);tira.setPixelColor(257,0,0,0);tira.setPixelColor(258,255,0,0);tira.setPixelColor(259,255,0,0);tira.setPixelColor(260,255,0,0);tira.setPixelColor(261,255,0,0);tira.setPixelColor(262,255,0,0);tira.setPixelColor(263,0,0,0);tira.setPixelColor(264,0,0,0);tira.setPixelColor(265,0,0,0);tira.setPixelColor(266,0,0,0);tira.setPixelColor(267,0,0,0);tira.setPixelColor(268,0,0,0);tira.setPixelColor(269,0,0,0);tira.setPixelColor(270,0,0,0);tira.setPixelColor(271,0,0,0);tira.setPixelColor(272,0,0,0);tira.setPixelColor(273,0,0,0);tira.setPixelColor(274,0,0,0);tira.setPixelColor(275,0,0,0);tira.setPixelColor(276,0,0,0);tira.setPixelColor(277,255,0,0);tira.setPixelColor(278,255,0,0);tira.setPixelColor(279,255,0,0);tira.setPixelColor(280,0,0,0);tira.setPixelColor(281,0,0,0);tira.setPixelColor(282,0,0,0);tira.setPixelColor(283,0,0,0);tira.setPixelColor(284,0,0,0);tira.setPixelColor(285,0,0,0);tira.setPixelColor(286,0,0,0);tira.setPixelColor(287,0,0,0);
      tira.show();
      break;
//Estrella
      case 'S':
      tira.setPixelColor(0,0,0,0);tira.setPixelColor(1,0,0,0);tira.setPixelColor(2,0,0,0);tira.setPixelColor(3,0,0,0);tira.setPixelColor(4,0,0,0);tira.setPixelColor(5,0,0,0);tira.setPixelColor(6,0,0,0);tira.setPixelColor(7,0,0,0);tira.setPixelColor(8,255,255,0);tira.setPixelColor(9,255,255,0);tira.setPixelColor(10,0,0,0);tira.setPixelColor(11,0,0,0);tira.setPixelColor(12,0,0,0);tira.setPixelColor(13,0,0,0);tira.setPixelColor(14,0,0,0);tira.setPixelColor(15,0,0,0);tira.setPixelColor(16,0,0,0);tira.setPixelColor(17,0,0,0);tira.setPixelColor(18,0,0,0);tira.setPixelColor(19,0,0,0);tira.setPixelColor(20,0,0,0);tira.setPixelColor(21,0,0,0);tira.setPixelColor(22,0,0,0);tira.setPixelColor(23,0,0,0);tira.setPixelColor(24,0,0,0);tira.setPixelColor(25,0,0,0);tira.setPixelColor(26,255,255,0);tira.setPixelColor(27,255,255,0);tira.setPixelColor(28,0,0,0);tira.setPixelColor(29,0,0,0);tira.setPixelColor(30,0,0,0);tira.setPixelColor(31,0,0,0);tira.setPixelColor(32,0,0,0);tira.setPixelColor(33,0,0,0);tira.setPixelColor(34,0,0,0);tira.setPixelColor(35,0,0,0);tira.setPixelColor(36,0,0,0);tira.setPixelColor(37,0,0,0);tira.setPixelColor(38,0,0,0);tira.setPixelColor(39,0,0,0);tira.setPixelColor(40,0,0,0);tira.setPixelColor(41,0,0,0);tira.setPixelColor(42,0,0,0);tira.setPixelColor(43,255,255,0);tira.setPixelColor(44,255,255,0);tira.setPixelColor(45,255,255,0);tira.setPixelColor(46,255,255,0);tira.setPixelColor(47,0,0,0);tira.setPixelColor(48,0,0,0);tira.setPixelColor(49,0,0,0);tira.setPixelColor(50,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
PixelColor(284,0,0,0);tira.setPixelColor(285,0,0,0);tira.setPixelColor(286,255,255,0);tira.setPixelColor(287,255,255,0);
      tira.show();
      break;
//Fantasma     
      case 'G':
      tira.setPixelColor(0,0,0,0);tira.setPixelColor(1,0,0,0);tira.setPixelColor(2,0,0,0);tira.setPixelColor(3,0,0,0);tira.setPixelColor(4,255,255,255);tira.setPixelColor(5,255,255,255);tira.setPixelColor(6,0,0,0);tira.setPixelColor(7,0,0,0);tira.setPixelColor(8,0,0,0);tira.setPixelColor(9,0,0,0);tira.setPixelColor(10,255,255,255);tira.setPixelColor(11,255,255,255);tira.setPixelColor(12,255,255,255);tira.setPixelColor(13,0,0,0);tira.setPixelColor(14,0,0,0);tira.setPixelColor(15,0,0,0);tira.setPixelColor(16,0,0,0);tira.setPixelColor(17,0,0,0);tira.setPixelColor(18,0,0,0);tira.setPixelColor(19,0,0,0);tira.setPixelColor(20,0,0,0);tira.setPixelColor(21,255,255,255);tira.setPixelColor(22,0,0,0);tira.setPixelColor(23,0,0,0);tira.setPixelColor(24,255,255,255);tira.setPixelColor(25,255,255,255);tira.setPixelColor(26,255,255,255);tira.setPixelColor(27,255,255,255);tira.setPixelColor(28,0,0,0);tira.setPixelColor(29,0,0,0);tira.setPixelColor(30,255,255,255);tira.setPixelColor(31,255,255,255);tira.setPixelColor(32,0,0,0);tira.setPixelColor(33,0,0,0);tira.setPixelColor(34,0,0,0);tira.setPixelColor(35,0,0,0);tira.setPixelColor(36,0,0,0);tira.setPixelColor(37,0,0,0);tira.setPixelColor(38,255,255,255);tira.setPixelColor(39,0,0,0);tira.setPixelColor(40,255,255,255);tira.setPixelColor(41,255,255,255);tira.setPixelColor(42,255,255,255);tira.setPixelColor(43,255,255,255);tira.setPixelColor(44,255,255,255);tira.setPixelColor(45,255,255,255);tira.setPixelColor(46,255,255,255);tira.setPixelColor(47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
210,105,30);tira.setPixelColor(273,210,105,30);tira.setPixelColor(274,210,105,30);tira.setPixelColor(275,255,255,255);tira.setPixelColor(276,255,255,255);tira.setPixelColor(277,255,255,255);tira.setPixelColor(278,255,255,255);tira.setPixelColor(279,0,0,0);tira.setPixelColor(280,0,0,0);tira.setPixelColor(281,0,0,0);tira.setPixelColor(282,0,0,0);tira.setPixelColor(283,0,0,0);tira.setPixelColor(284,0,0,0);tira.setPixelColor(285,255,255,255);tira.setPixelColor(286,0,0,0);tira.setPixelColor(287,0,0,0);
      tira.show();
      break;
//Protector
      case 'P':
      tira.setPixelColor(0,0,255,0);tira.setPixelColor(1,0,255,0);tira.setPixelColor(2,0,255,0);tira.setPixelColor(3,0,255,0);tira.setPixelColor(4,255,127,8);tira.setPixelColor(5,255,127,8);tira.setPixelColor(6,255,127,8);tira.setPixelColor(7,255,127,8);tira.setPixelColor(8,0,255,255);tira.setPixelColor(9,0,255,255);tira.setPixelColor(10,0,255,255);tira.setPixelColor(11,0,255,255);tira.setPixelColor(12,0,0,255);tira.setPixelColor(13,0,0,255);tira.setPixelColor(14,0,0,255);tira.setPixelColor(15,0,0,255);tira.setPixelColor(16,255,0,255);tira.setPixelColor(17,255,0,255);tira.setPixelColor(18,0,255,0);tira.setPixelColor(19,0,255,0);tira.setPixelColor(20,0,255,0);tira.setPixelColor(21,0,255,0);tira.setPixelColor(22,255,127,8);tira.setPixelColor(23,255,127,8);tira.setPixelColor(24,255,127,8);tira.setPixelColor(25,255,127,8);tira.setPixelColor(26,0,255,255);tira.setPixelColor(27,0,255,255);tira.setPixelColor(28,0,255,255);tira.setPixelColor(29,0,255,255);tira.setPixelColor(30,0,0,255);tira.setPixelColor(31,0,0,255);tira.setPixelColor(32,0,0,255);tira.setPixelColor(33,0,0,255);tira.setPixelColor(34,255,0,255);tira.setPixelColor(35,255,0,255);tira.setPixelColor(36,0,255,0);tira.setPixelColor(37,0,255,0);tira.setPixelColor(38,0,255,0);tira.setPixelColor(39,0,255,0);tira.setPixelColor(40,255,127,8);tira.setPixelColor(41,255,127,8);tira.setPixelColor(42,255,127,8);tira.setPixelColor(43,255,127,8);tira.setPixelColor(44,0,255,255);tira.setPixelColor(45,0,255,255);tira.setPixelColor(46,0,25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
ra.setPixelColor(275,255,127,8);tira.setPixelColor(276,255,127,8);tira.setPixelColor(277,255,127,8);tira.setPixelColor(278,0,255,255);tira.setPixelColor(279,0,255,255);tira.setPixelColor(280,0,255,255);tira.setPixelColor(281,0,255,255);tira.setPixelColor(282,0,0,255);tira.setPixelColor(283,0,0,255);tira.setPixelColor(284,0,0,255);tira.setPixelColor(285,0,0,255);tira.setPixelColor(286,255,0,255);tira.setPixelColor(287,255,0,255);
      tira.show();
      break;
//Descanso
      case 'Z':
      tira.setPixelColor(0,0,0,0);tira.setPixelColor(1,0,0,0);tira.setPixelColor(2,0,0,0);tira.setPixelColor(3,0,0,0);tira.setPixelColor(4,0,0,0);tira.setPixelColor(5,0,0,0);tira.setPixelColor(6,0,0,0);tira.setPixelColor(7,0,0,0);tira.setPixelColor(8,0,0,0);tira.setPixelColor(9,0,0,0);tira.setPixelColor(10,0,0,0);tira.setPixelColor(11,0,0,0);tira.setPixelColor(12,0,0,0);tira.setPixelColor(13,0,0,0);tira.setPixelColor(14,0,0,0);tira.setPixelColor(15,0,0,0);tira.setPixelColor(16,0,0,0);tira.setPixelColor(17,0,0,0);tira.setPixelColor(18,0,0,0);tira.setPixelColor(19,0,0,0);tira.setPixelColor(20,0,0,0);tira.setPixelColor(21,0,0,0);tira.setPixelColor(22,0,0,0);tira.setPixelColor(23,0,0,0);tira.setPixelColor(24,0,0,0);tira.setPixelColor(25,0,0,0);tira.setPixelColor(26,0,0,0);tira.setPixelColor(27,0,0,0);tira.setPixelColor(28,0,0,0);tira.setPixelColor(29,210,105,30);tira.setPixelColor(30,210,105,30);tira.setPixelColor(31,210,105,30);tira.setPixelColor(32,0,0,0);tira.setPixelColor(33,0,0,0);tira.setPixelColor(34,0,0,0);tira.setPixelColor(35,0,0,0);tira.setPixelColor(36,0,0,0);tira.setPixelColor(37,0,0,0);tira.setPixelColor(38,0,0,0);tira.setPixelColor(39,0,0,0);tira.setPixelColor(40,0,0,0);tira.setPixelColor(41,0,0,0);tira.setPixelColor(42,0,0,0);tira.setPixelColor(43,0,0,0);tira.setPixelColor(44,0,0,0);tira.setPixelColor(45,0,0,0);tira.setPixelColor(46,0,0,0);tira.setPixelColor(47,0,0,0);tira.setPixelColor(48,0,0,0);tira.setPixelColor(49,210,105,30);tira.setPixelColor(50,0,0,0);tira.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
;tira.setPixelColor(200,0,0,0);tira.setPixelColor(201,0,0,0);tira.setPixelColor(202,0,0,0);tira.setPixelColor(203,210,105,30);tira.setPixelColor(204,0,0,0);tira.setPixelColor(205,0,0,0);tira.setPixelColor(206,0,0,0);tira.setPixelColor(207,0,0,0);tira.setPixelColor(208,0,0,0);tira.setPixelColor(209,0,0,0);tira.setPixelColor(210,0,0,0);tira.setPixelColor(211,0,0,0);tira.setPixelColor(212,0,0,0);tira.setPixelColor(213,0,0,0);tira.setPixelColor(214,0,0,0);tira.setPixelColor(215,0,0,0);tira.setPixelColor(216,0,0,0);tira.setPixelColor(217,0,0,0);tira.setPixelColor(218,0,0,0);tira.setPixelColor(219,0,0,0);tira.setPixelColor(220,210,105,30);tira.setPixelColor(221,0,0,0);tira.setPixelColor(222,0,0,0);tira.setPixelColor(223,0,0,0);tira.setPixelColor(224,0,0,0);tira.setPixelColor(225,0,0,0);tira.setPixelColor(226,0,0,0);tira.setPixelColor(227,0,0,0);tira.setPixelColor(228,0,0,0);tira.setPixelColor(229,0,0,0);tira.setPixelColor(230,0,0,0);tira.setPixelColor(231,0,0,0);tira.setPixelColor(232,0,0,0);tira.setPixelColor(233,0,0,0);tira.setPixelColor(234,0,0,0);tira.setPixelColor(235,0,0,0);tira.setPixelColor(236,0,0,0);tira.setPixelColor(237,210,105,30);tira.setPixelColor(238,0,0,0);tira.setPixelColor(239,0,0,0);tira.setPixelColor(240,0,0,0);tira.setPixelColor(241,0,0,0);tira.setPixelColor(242,0,0,0);tira.setPixelColor(243,0,0,0);tira.setPixelColor(244,0,0,0);tira.setPixelColor(245,0,0,0);tira.setPixelColor(246,0,0,0);tira.setPixelColor(247,0,0,0);tira.setPixelColor(248,0,0,0);tira.setPixelColor(249,0,0,0);tira.setPixelColor(250,0,0,0);tira.setPixelColor(251,0,0,0);tira.setPixelColor(252,0,0,0);tira.setPixelColor(253,0,0,0);tira.setPixelColor(254,0,0,0);tira.setPixelColor(255,210,105,30);tira.setPixelColor(256,210,105,30);tira.setPixelColor(257,210,105,30);tira.setPixelColor(258,0,0,0);tira.setPixelColor(259,0,0,0);tira.setPixelColor(260,0,0,0);tira.setPixelColor(261,0,0,0);tira.setPixelColor(262,0,0,0);tira.setPixelColor(263,0,0,0);tira.setPixelColor(264,0,0,0);tira.setPixelColor(265,0,0,0);tira.setPixelColor(266,0,0,0);tira.setPixelColor(267,0,0,0);tira.setPixelColor(268,0,0,0);tira.setPixelColor(269,0,0,0);tira.setPixelColor(270,0,0,0);tira.setPixelColor(271,0,0,0);tira.setPixelColor(272,0,0,0);tira.setPixelColor(273,0,0,0);tira.setPixelColor(274,0,0,0);tira.setPixelColor(275,0,0,0);tira.setPixelColor(276,0,0,0);tira.setPixelColor(277,0,0,0);tira.setPixelColor(278,0,0,0);tira.setPixelColor(279,0,0,0);tira.setPixelColor(280,0,0,0);tira.setPixelColor(281,0,0,0);tira.setPixelColor(282,0,0,0);tira.setPixelColor(283,0,0,0);tira.setPixelColor(284,0,0,0);tira.setPixelColor(285,0,0,0);tira.setPixelColor(286,0,0,0);tira.setPixelColor(287,0,0,0);
      tira.show();
      break;
//Dinosaurio
      case 'Q':
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
